IC-LuanPacheco/Projeto-de-IC/README.md

# Projeto-de-IC
Projeto submetido ao PROIC UEL 2023
