IC-LuanPacheco/Projeto-de-IC/Modelos/SolidWorks/Acelerometro_Modificado/Montagem_Experiemnto.SLDASM

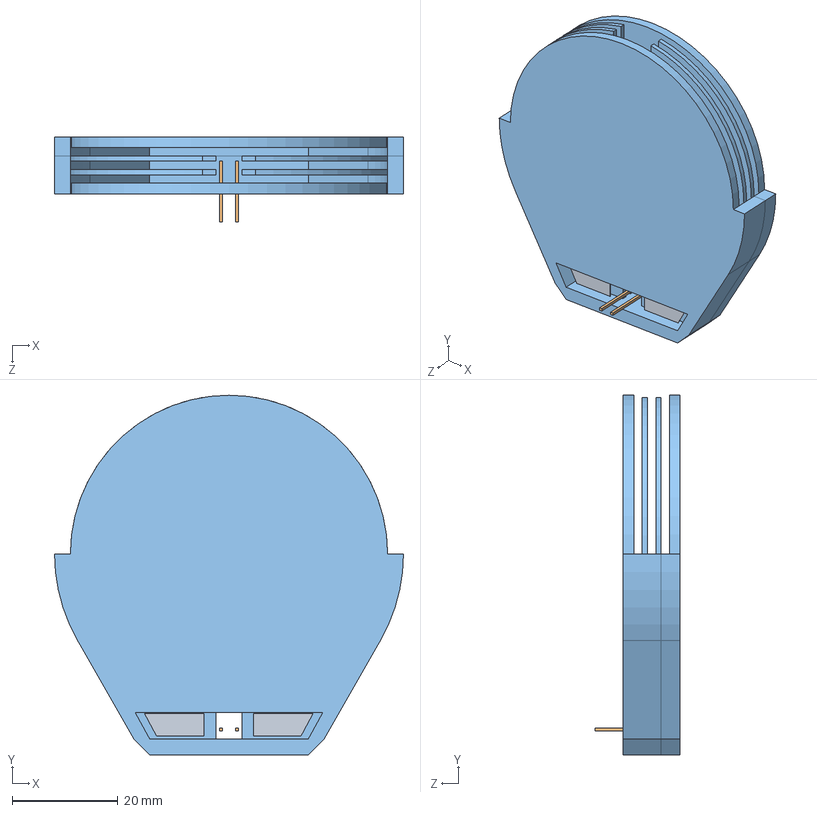
[picture p33: CAD file, 2024-02-15]
Modelos/SolidWorks/Acelerometro_Modificado/Montagem_Experiemnto.SLDASM
66.0 x 68.0 x 16.1 mm
Backup_Espaçador_experimento_tamanho placas
pino x 2
cobre_tampa x 4
