IC-LuanPacheco/Projeto-de-IC/Modelos/SolidWorks/Acelerometro/Acelerometro_Montagem.SLDASM

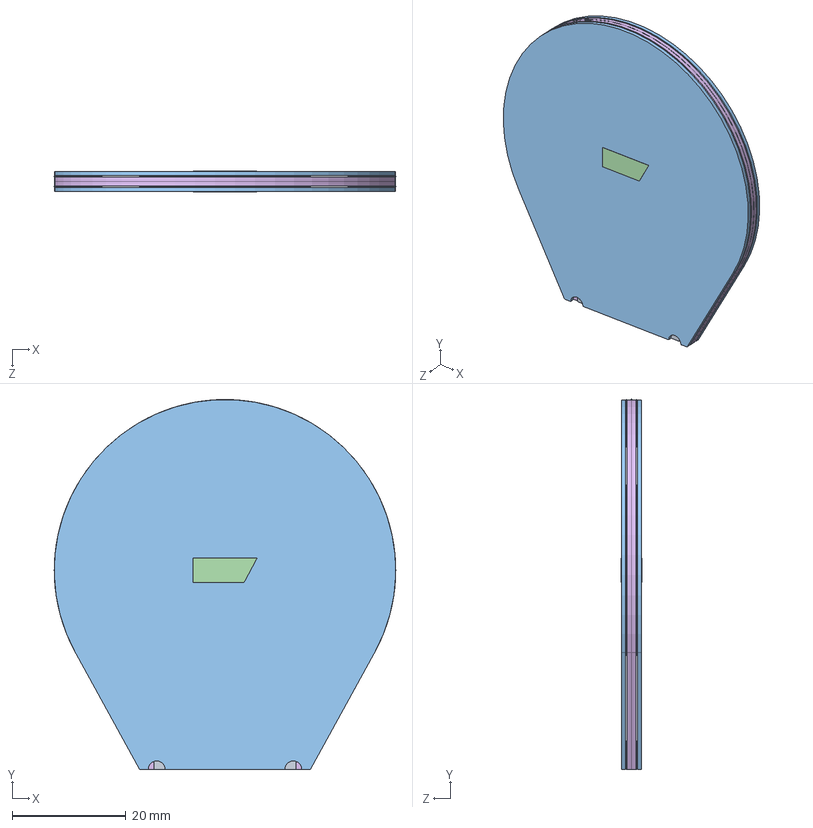
[picture p34: CAD file, 2024-01-25]
Modelos/SolidWorks/Acelerometro/Acelerometro_Montagem.SLDASM
60.0 x 65.0 x 3.67 mm
Dieletrico1 x 2
Cobre_Central
Cobre_tampa x 4
Dieletrico_tampa x 2
Espaçador x 6
Espaçador_inferior x 2
