IC-LuanPacheco/Projeto-de-IC/Modelos/SolidWorks/Acelerometro/Tampa.SLDASM

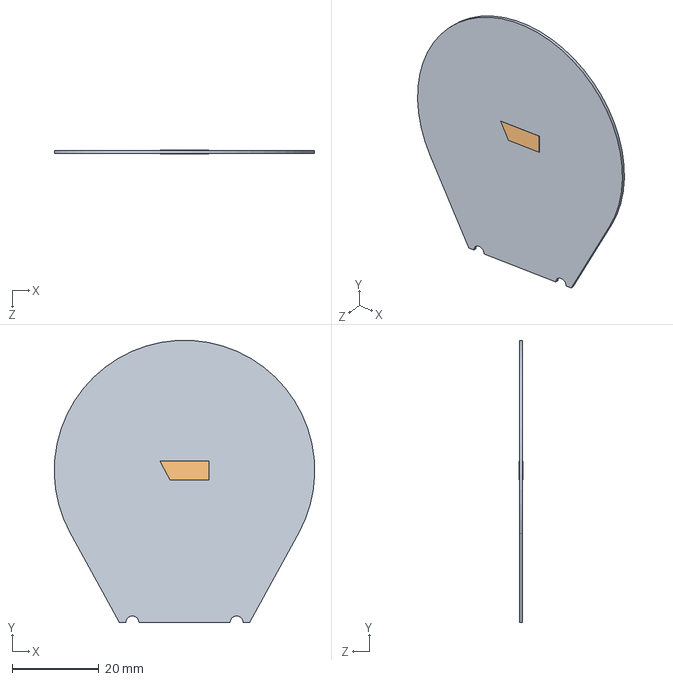
[picture p35: CAD file, 2024-01-25]
Modelos/SolidWorks/Acelerometro/Tampa.SLDASM
60.0 x 64.9 x 0.825 mm
Cobre_tampa x 2
Dieletrico_tampa
