IC-LuanPacheco/Projeto-de-IC/Modelos/Altium/PCB_Project/Step_Placas/Montagem_06_03_24/Tampa_Alinhada.step

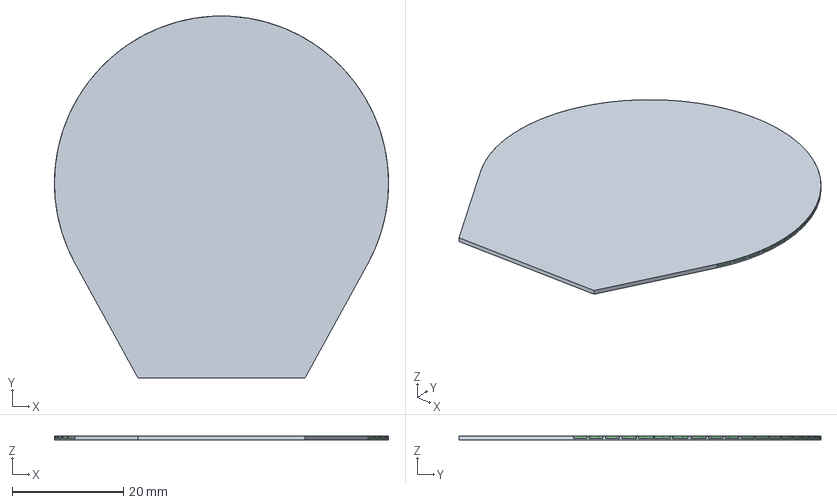
[picture p36: CAD file, 2024-04-25]
Modelos/Altium/PCB_Project/Step_Placas/Montagem_06_03_24/Tampa_Alinhada.step
60.0 x 65.0 x 0.754 mm
Tampa_modelo_3D x 2
