IC-LuanPacheco/Projeto-de-IC/Modelos/Altium/PCB_Project/Step_Placas/Transdutor_Modelo_3D.STEP

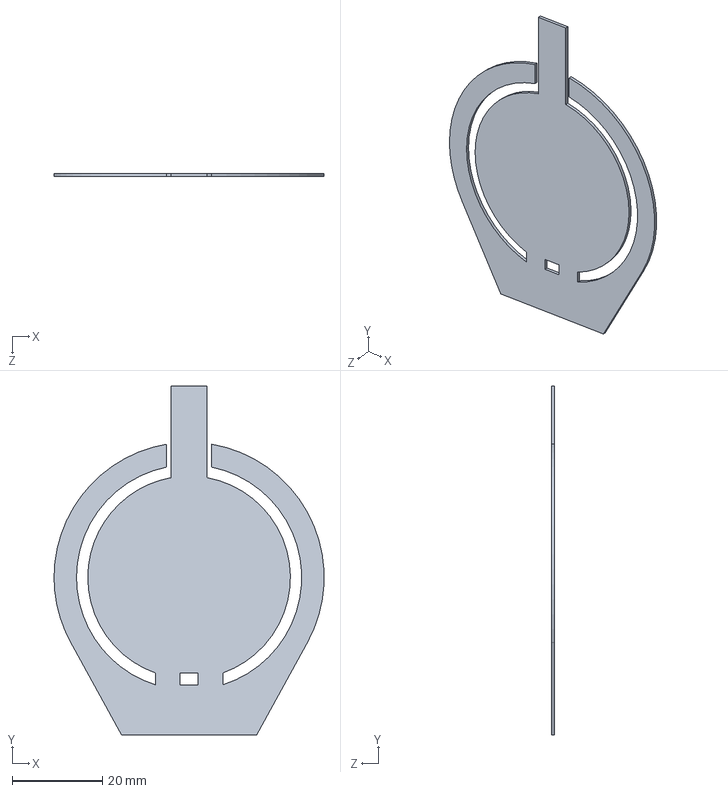
[picture p37: CAD file, 2024-04-25]
Modelos/Altium/PCB_Project/Step_Placas/Transdutor_Modelo_3D.STEP
60.0 x 77.5 x 0.754 mm
