IC-LuanPacheco/Projeto-de-IC/Modelos/SolidWorks/Acelerometro_Modificado/Espaçador_experimento.SLDPRT

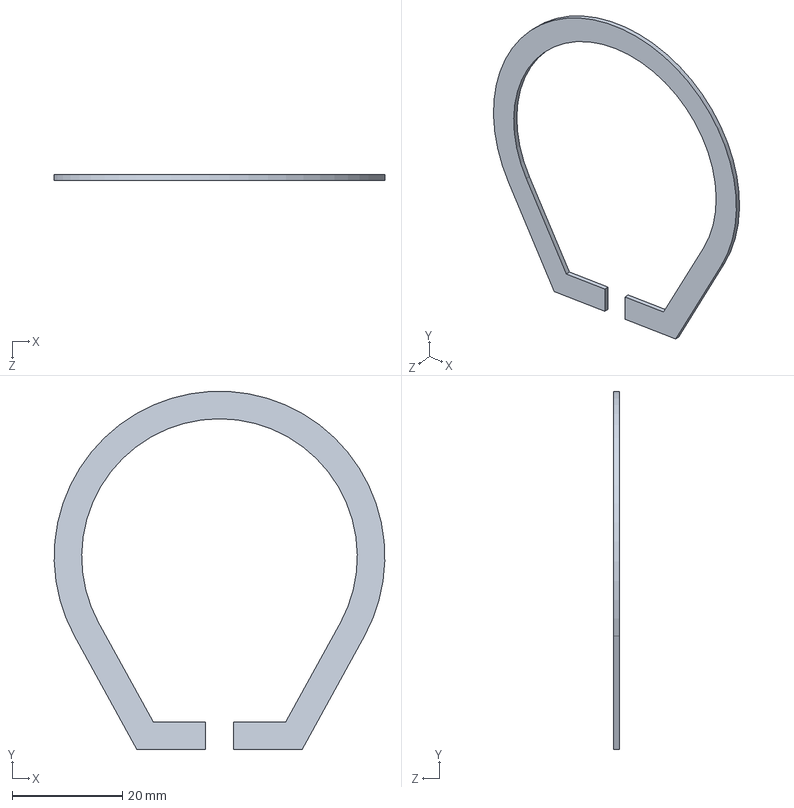
[picture p39: CAD file, 2024-02-15]
Modelos/SolidWorks/Acelerometro_Modificado/Espaçador_experimento.SLDPRT
60.0 x 64.9 x 1.00 mm
