IC-LuanPacheco/Projeto-de-IC/Modelos/SolidWorks/Acelerometro_Modificado/Modelos_Step/Acelerometro_tampa_2.step

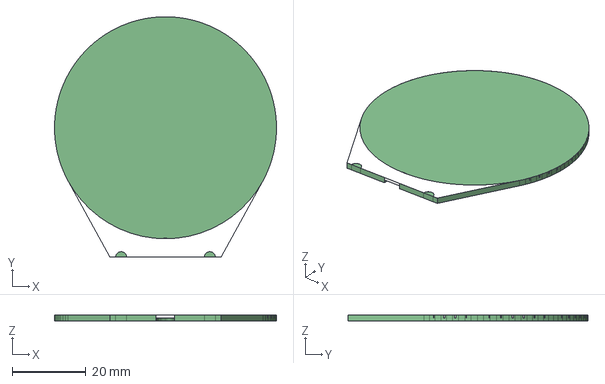
[picture p40: CAD file, 2024-02-15]
Modelos/SolidWorks/Acelerometro_Modificado/Modelos_Step/Acelerometro_tampa_2.step
60.0 x 65.0 x 1.60 mm
