IC-LuanPacheco/Projeto-de-IC/Modelos/Altium/PCB_Project/Step_Placas/Montagem_10_02_24/Acelerometro_4Layers.step

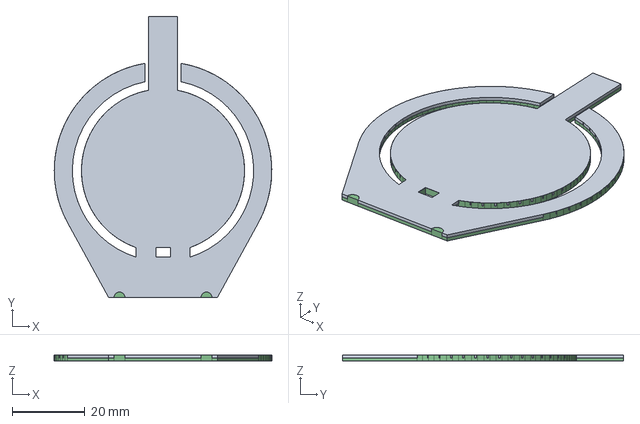
[picture p41: CAD file, 2024-02-15]
Modelos/Altium/PCB_Project/Step_Placas/Montagem_10_02_24/Acelerometro_4Layers.step
60.0 x 77.5 x 1.58 mm
dieletrico_haste_3
