IC-LuanPacheco/Projeto-de-IC/Modelos/Altium/PCB_Project/Step_Placas/tampa_modelo_3d.step.DXF

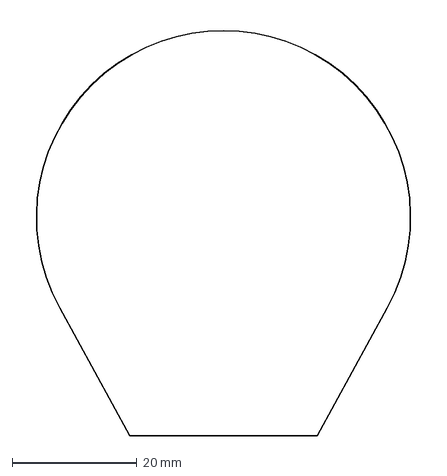
[picture p42: CAD file, 2024-04-25]
Modelos/Altium/PCB_Project/Step_Placas/tampa_modelo_3d.step.DXF
66.5 x 67.3 mm
