IC-LuanPacheco/Projeto-de-IC/Modelos/SolidWorks/Acelerometro/Cobre1.STEP

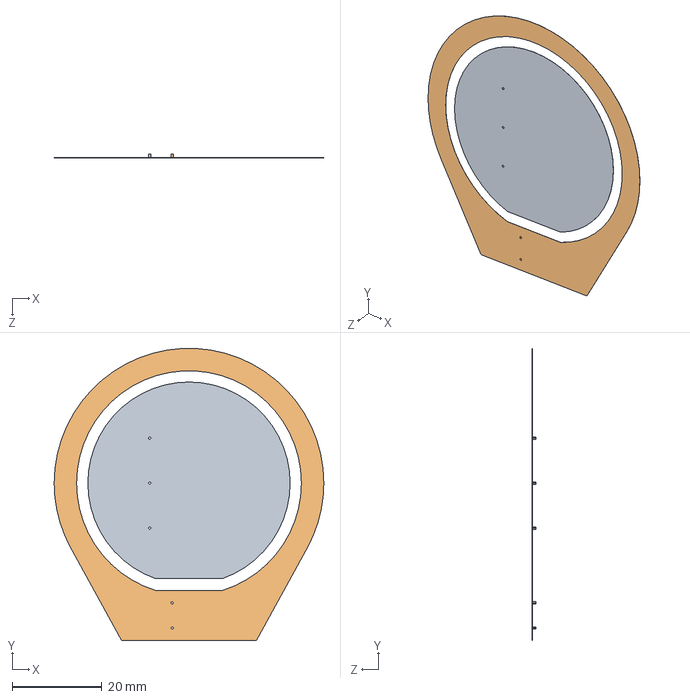
[picture p43: CAD file, 2024-02-07]
Modelos/SolidWorks/Acelerometro/Cobre1.STEP
60.0 x 65.0 x 0.79 mm
