IC-LuanPacheco/Projeto-de-IC/Modelos/SolidWorks/Acelerometro_Modificado/Backup_Espaçador_experimento_tamanho placas.SLDPRT

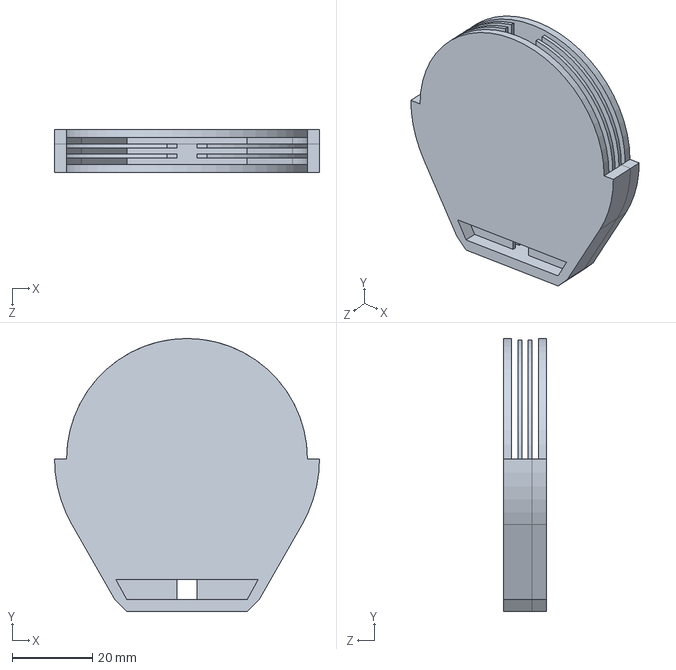
[picture p44: CAD file, 2024-02-15]
Modelos/SolidWorks/Acelerometro_Modificado/Backup_Espaçador_experimento_tamanho placas.SLDPRT
66.0 x 68.0 x 10.8 mm
