IC-LuanPacheco/Projeto-de-IC/Modelos/SolidWorks/Acelerometro_Modificado/Modelos_Step/cobre_tampa.SLDPRT

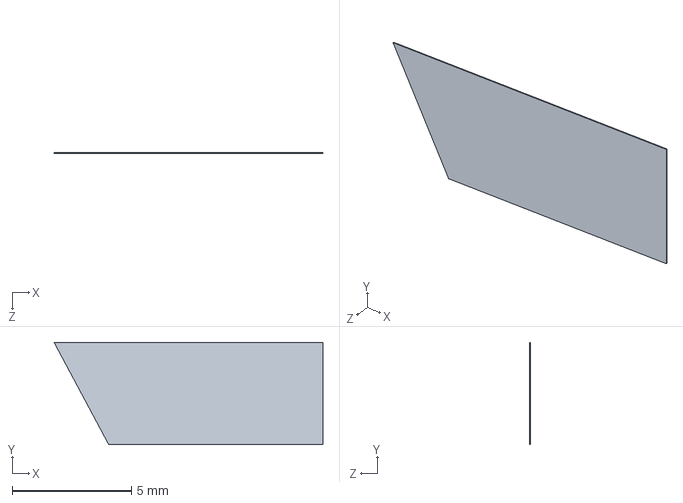
[picture p45: CAD file, 2024-02-15]
Modelos/SolidWorks/Acelerometro_Modificado/Modelos_Step/cobre_tampa.SLDPRT
11.3 x 4.30 x 0.035 mm
