IC-LuanPacheco/Projeto-de-IC/Modelos/Altium/PCB_Project/Step_Placas/Montagem_06_03_24/Transdutor_Alinhado.step

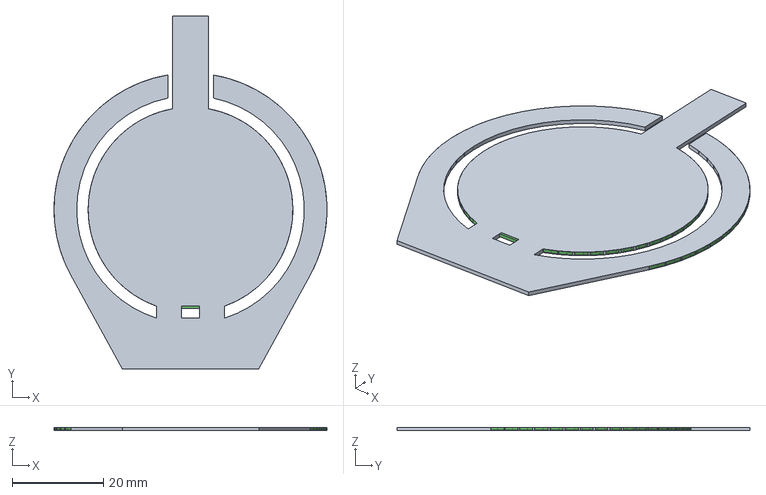
[picture p46: CAD file, 2024-04-25]
Modelos/Altium/PCB_Project/Step_Placas/Montagem_06_03_24/Transdutor_Alinhado.step
60.0 x 77.5 x 0.754 mm
Transdutor_Modelo_3D
