IC-LuanPacheco/Projeto-de-IC/Modelos/Altium/PCB_Project/Step_Placas/Montagem_10_02_24/Acelerometro_tampa_traseira.step

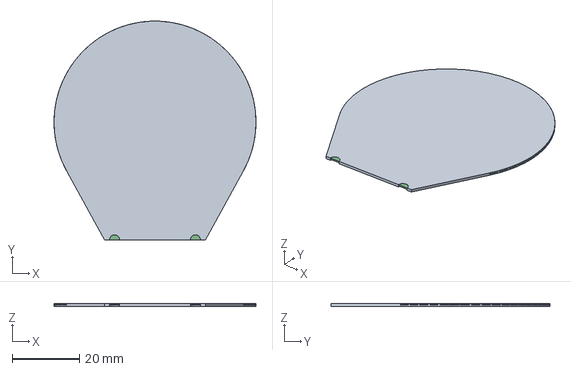
[picture p47: CAD file, 2024-02-15]
Modelos/Altium/PCB_Project/Step_Placas/Montagem_10_02_24/Acelerometro_tampa_traseira.step
60.0 x 65.0 x 0.754 mm
Dieletrico_tampa_frente
