IC-LuanPacheco/Projeto-de-IC/Modelos/Altium/PCB_Project/Step_Placas/Tampa_modelo_3D.STEP

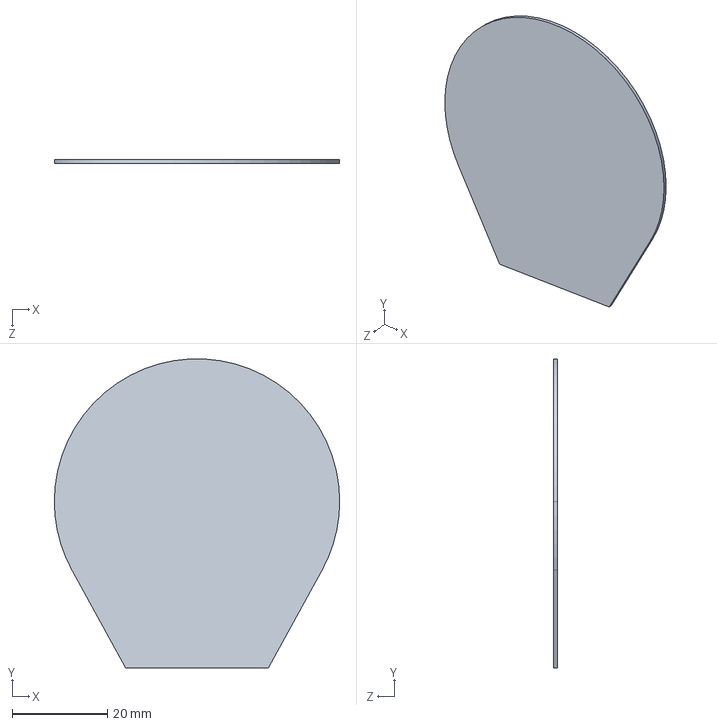
[picture p48: CAD file, 2024-04-25]
Modelos/Altium/PCB_Project/Step_Placas/Tampa_modelo_3D.STEP
60.0 x 65.0 x 0.754 mm
