IC-LuanPacheco/Projeto-de-IC/Modelos/SolidWorks/Acelerometro_Modificado/Modelos_Step/Acelerometro_4Layers.step

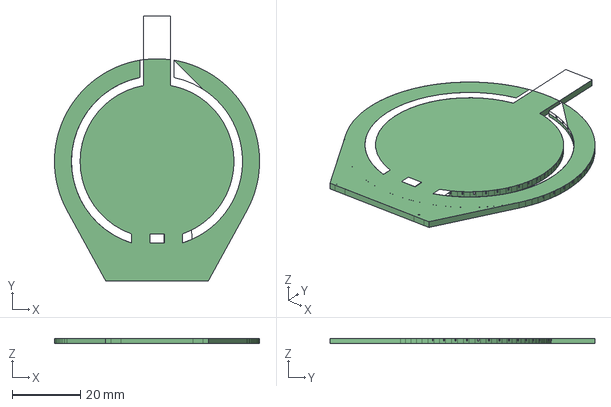
[picture p49: CAD file, 2024-02-15]
Modelos/SolidWorks/Acelerometro_Modificado/Modelos_Step/Acelerometro_4Layers.step
60.0 x 77.5 x 1.58 mm
