IC-LuanPacheco/Projeto-de-IC/Modelos/SolidWorks/Acelerometro/Dieletrico1.SLDPRT

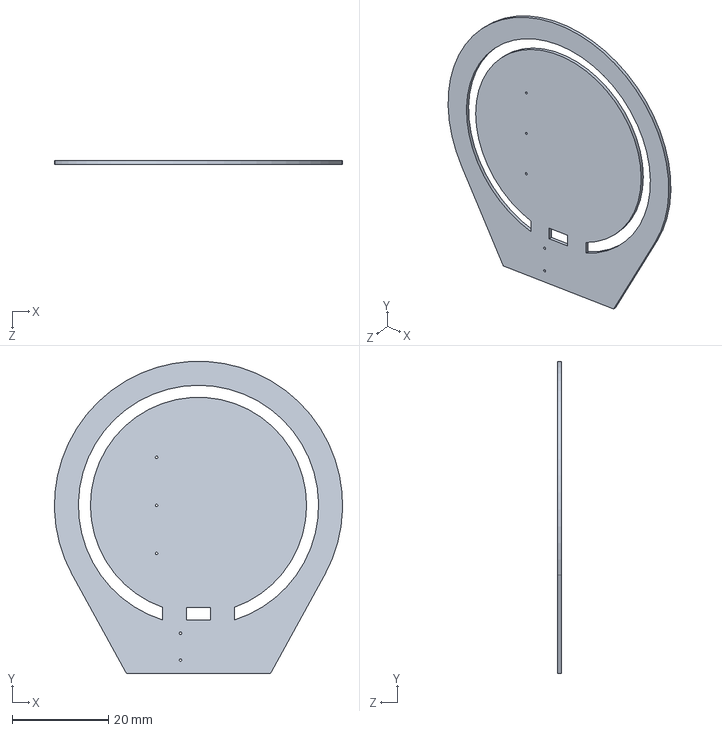
[picture p50: CAD file, 2024-01-25]
Modelos/SolidWorks/Acelerometro/Dieletrico1.SLDPRT
60.0 x 64.9 x 0.754 mm
