IC-LuanPacheco/Projeto-de-IC/Modelos/SolidWorks/Acelerometro_Modificado/Modelos_Step/pino.SLDPRT

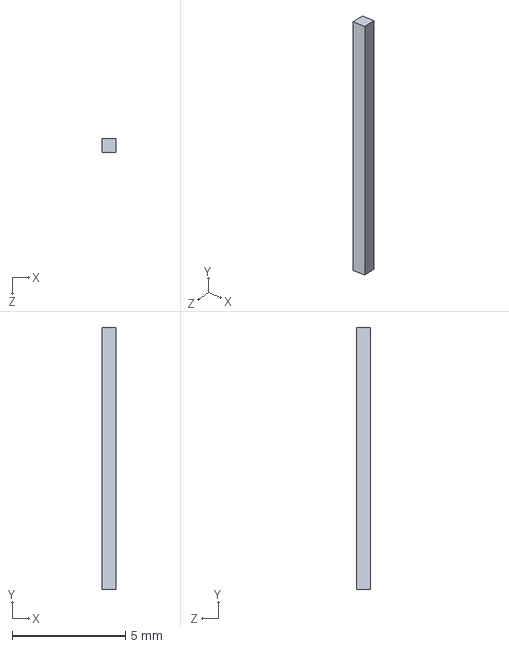
[picture p51: CAD file, 2024-02-15]
Modelos/SolidWorks/Acelerometro_Modificado/Modelos_Step/pino.SLDPRT
0.6 x 11.6 x 0.6 mm
