IC-LuanPacheco/Projeto-de-IC/Modelos/SolidWorks/Acelerometro/Acelerometro_Montagem_Part.SLDPRT

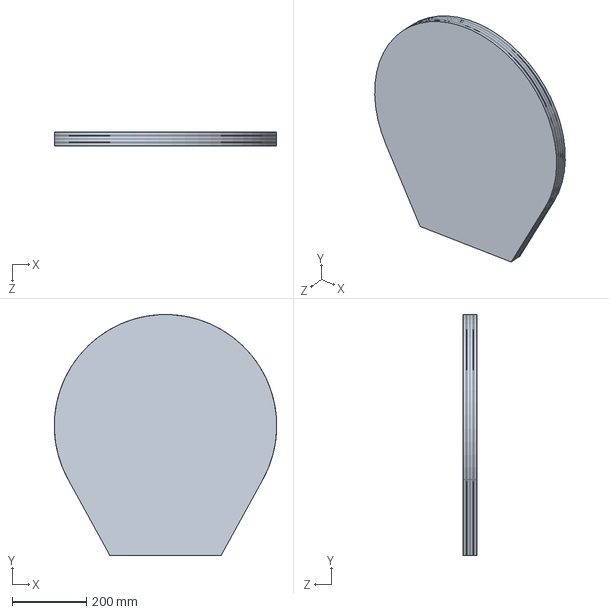
[picture p52: CAD file, 2024-01-25]
Modelos/SolidWorks/Acelerometro/Acelerometro_Montagem_Part.SLDPRT
600.0 x 650.0 x 36.7 mm
