IC-LuanPacheco/Projeto-de-IC/Modelos/Altium/PCB_Project/Step_Placas/Montagem_22_02_24/acelerometro_tampa.STEP

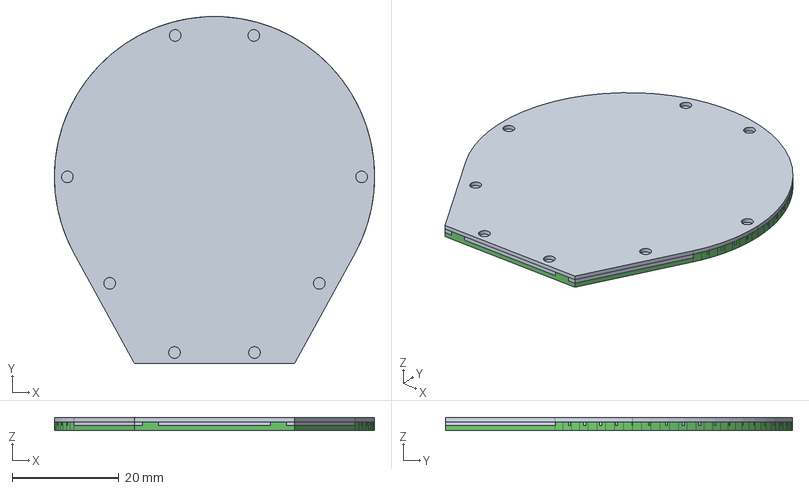
[picture p53: CAD file, 2024-02-22]
Modelos/Altium/PCB_Project/Step_Placas/Montagem_22_02_24/acelerometro_tampa.STEP
60.0 x 65.0 x 2.35 mm
acelerometro_tampa
Dieletrico_tampa_frente
