IC-LuanPacheco/Projeto-de-IC/Modelos/SolidWorks/Acelerometro/Espaçador.SLDPRT

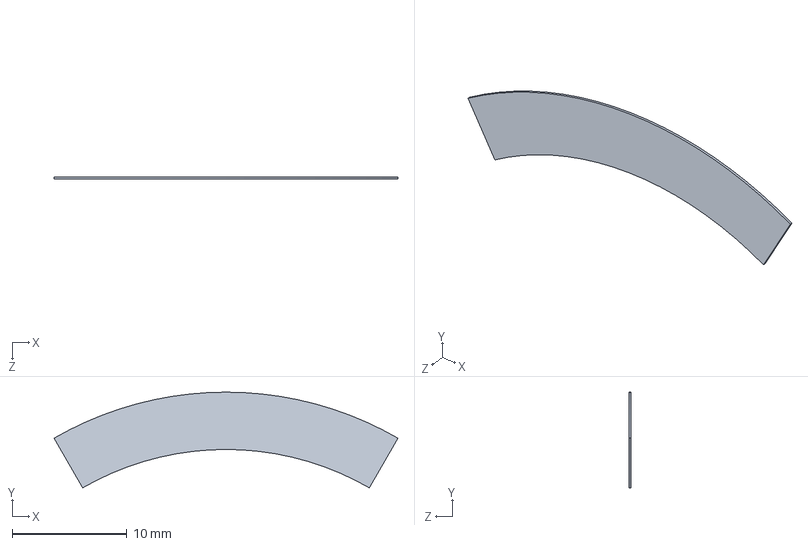
[picture p54: CAD file, 2024-01-25]
Modelos/SolidWorks/Acelerometro/Espaçador.SLDPRT
30.0 x 8.35 x 0.2 mm
