IC-LuanPacheco/Projeto-de-IC/Modelos/SolidWorks/Acelerometro/Cobre_Central.SLDPRT

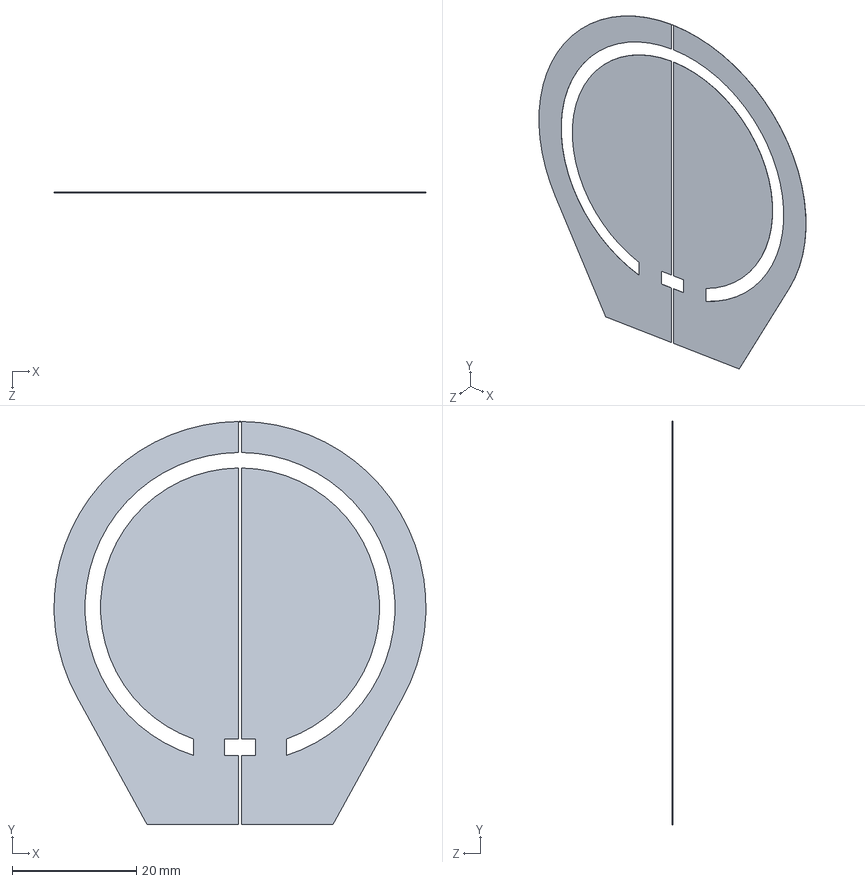
[picture p55: CAD file, 2024-01-25]
Modelos/SolidWorks/Acelerometro/Cobre_Central.SLDPRT
60.0 x 65.0 x 0.0356 mm
