IC-LuanPacheco/Projeto-de-IC/Modelos/SolidWorks/Acelerometro/Cobre_tampa.SLDPRT

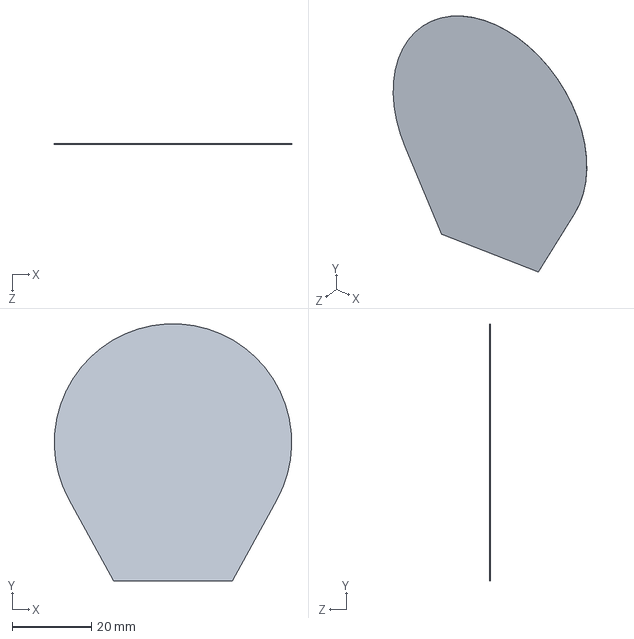
[picture p56: CAD file, 2024-01-25]
Modelos/SolidWorks/Acelerometro/Cobre_tampa.SLDPRT
60.0 x 64.9 x 0.0356 mm
