IC-LuanPacheco/Projeto-de-IC/Modelos/SolidWorks/Acelerometro/Espaçador_inferior.SLDPRT

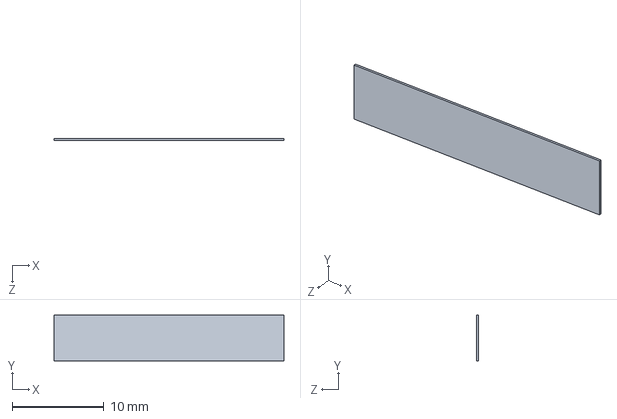
[picture p57: CAD file, 2024-01-25]
Modelos/SolidWorks/Acelerometro/Espaçador_inferior.SLDPRT
25.0 x 5.00 x 0.2 mm
