IC-LuanPacheco/Projeto-de-IC/Modelos/Altium/PCB_Project/Step_Placas/Montagem_22_02_24/acelerometro_tampa_2.SLDPRT

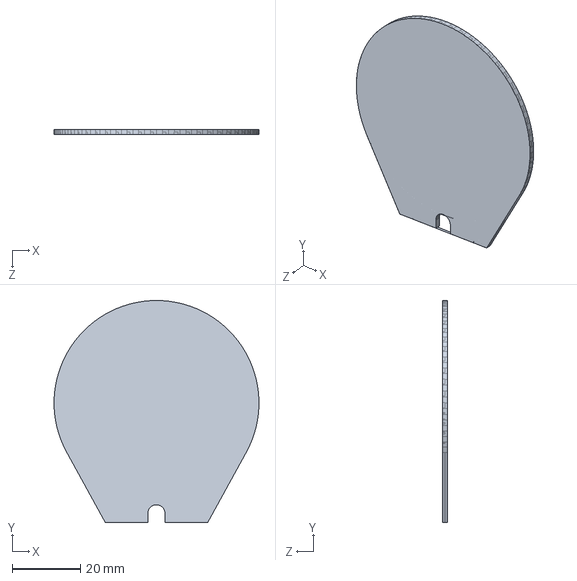
[picture p58: CAD file, 2024-02-15]
Modelos/Altium/PCB_Project/Step_Placas/Montagem_22_02_24/acelerometro_tampa_2.SLDPRT
60.0 x 65.0 x 1.60 mm
