IC-LuanPacheco/Projeto-de-IC/Modelos/Altium/PCB_Project/Step_Placas/Montagem_06_03_24/Montagem_06_03_24.SLDASM

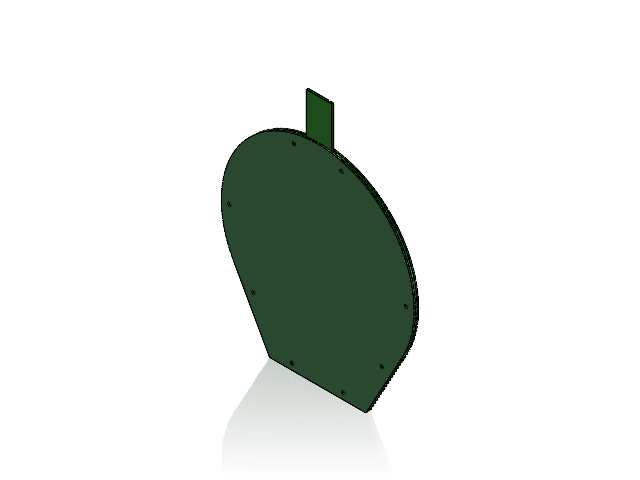
[picture p59: CAD file, 2024-04-25]
Modelos/Altium/PCB_Project/Step_Placas/Montagem_06_03_24/Montagem_06_03_24.SLDASM
