IC-LuanPacheco/Projeto-de-IC/Modelos/Altium/PCB_Project/Step_Placas/Montagem_22_02_24/Mont1.SLDASM

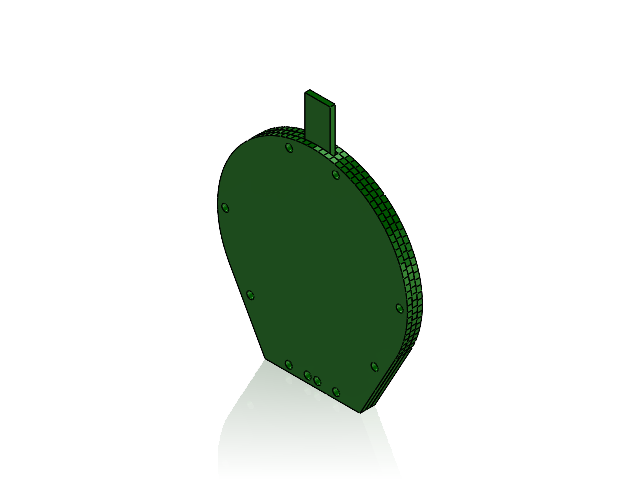
[picture p60: CAD file, 2024-02-22]
Modelos/Altium/PCB_Project/Step_Placas/Montagem_22_02_24/Mont1.SLDASM
