IC-LuanPacheco/Projeto-de-IC/(list of files, cad)

Other CAD files:
Modelos/Altium/PCB_Project/Step_Placas/Montagem_10_02_24/Board_1.step.SLDASM
Modelos/Altium/PCB_Project/Step_Placas/Montagem_06_03_24/Board_1.step.SLDASM
Modelos/Altium/PCB_Project/Step_Placas/Montagem_22_02_24/Board_3.step.SLDASM
Modelos/Altium/PCB_Project/Step_Placas/Montagem_22_02_24/Board_6.STEP.SLDASM
Modelos/Altium/PCB_Project/Step_Placas/Montagem_22_02_24/Board_4.step.SLDASM
Modelos/Altium/PCB_Project/Step_Placas/Montagem_22_02_24/Board_2.step.SLDASM
Modelos/Altium/PCB_Project/Step_Placas/Montagem_22_02_24/Open CASCADE STEP translator 7.5 2.1.1.STEP.SLDPRT
Modelos/Altium/PCB_Project/Step_Placas/Montagem_22_02_24/Dieletrico_tampa_frente.STEP.SLDPRT
Modelos/Altium/PCB_Project/Step_Placas/Montagem_22_02_24/Acelerometro_4Layers.step
Modelos/SolidWorks/Acelerometro/Dieletrico_tampa.SLDPRT
Modelos/Altium/PCB_Project/Step_Placas/Montagem_06_03_24/Open CASCADE STEP translator 7.5 4.1.1.step.SLDPRT
Modelos/Altium/PCB_Project/Step_Placas/Montagem_10_02_24/Acelerometro_tampa_frontal.step
Modelos/Altium/PCB_Project/Step_Placas/Montagem_22_02_24/Open CASCADE STEP translator 7.5 2.1.1_1.STEP.SLDPRT
Modelos/SolidWorks/Acelerometro_Modificado/dieletrico_haste_2.STEP
Modelos/SolidWorks/Acelerometro_Modificado/Dieletrico_tampa_frente.STEP
Modelos/Altium/PCB_Project/Step_Placas/Montagem_22_02_24/Dieletrico_tampa.SLDPRT
Modelos/SolidWorks/Acelerometro_Modificado/dieletrico_haste_3.STEP
Modelos/SolidWorks/Acelerometro_Modificado/dieletrico_haste.STEP
Modelos/SolidWorks/Acelerometro_Modificado/estudo_dimensoes.SLDPRT
Modelos/SolidWorks/Acelerometro/estudo_dimensoes.SLDPRT
Modelos/SolidWorks/Acelerometro/Cobre1.SLDPRT
Modelos/SolidWorks/Acelerometro_Modificado/Modelos_Step/acelerometro_4layers.SLDPRT
Modelos/SolidWorks/Acelerometro_Modificado/dieletrico_haste.SLDPRT
