IC-LuanPacheco/Projeto-de-IC/(list of files, drawings)

Other design files:
Modelos/Altium/PCB_Project/Acelerometro_tampa_frente.PcbDoc
Modelos/Altium/PCB_Project/Biblioteca_Squematico.SchLib
Modelos/Altium/PCB_Project/Nets_Acelerometro.SchDoc
Modelos/Altium/PCB_Project/PCB_Lib_Acelerometro.PcbLib
Modelos/Altium/PCB_Project/PCB_Project.PrjPcb
Modelos/Altium/PCB_Project/Tampa_Alinhada.PcbDoc
Modelos/Altium/PCB_Project/Transdutir_Alinhado.PcbDoc
