IC-LuanPacheco/Projeto-de-IC/(commit log)

2023-12-15 Vista explodida
    [Acelerometro_Montagem.SLDASM]
2024-01-25 Atualizações
    [Acel_PCB1.PcbDoc, Acel_PCB1.step, Acel_Sheet1.SchDoc, Acelerometro_Capacitivo.PrjPcb, Acelerometro_Montagem.SLDASM, Acelerometro_Montagem_Part.SLDPRT, Capacitor_Peca_Interna.STEP, Cobre1.SLDPRT]
2024-02-07 atualizacoes do modelo para o experimento Altium
    [Acel_PCB1.PcbDoc, Acel_PCB1.step, Acel_Sheet1.SchDoc, Acelerometro_4Layers.PcbDoc, Acelerometro_Capacitivo.PrjPcb, Acelerometro_Montagem.SLDASM, Acelerometro_Montagem_Part.SLDPRT, Acelerometro_Tampa.PrjPcb]
2024-02-11 Atualizações do transdutor e placas paralelas
    [Acel_PCB1.PcbDoc, Acel_PCB1.step, Acel_Sheet1.SchDoc, Acelerometro_4Layers.PcbDoc, Acelerometro_Capacitivo.PrjPcb, Acelerometro_Tampa.PrjPcb, Acelerometro_tampa_frente.PcbDoc, Acelerometro_tampa_sheet.SchDoc]
2024-02-15 Montagem SolidWorks e Placas prontas no Altiunm
    [Acelerometro_4Layers.PcbDoc, Acelerometro_4Layers.step, Acelerometro_Montagem_step.STEP, Acelerometro_tampa_2.PcbDoc, Acelerometro_tampa_2.step, Acelerometro_tampa_frente.PcbDoc, Acelerometro_tampa_frontal.step, Acelerometro_tampa_traseira.step]
2024-02-22 Pasta -Altium- atualizada, modelo do capacitor com furos para fixacao
    [Acelerometro_4Layers.PcbDoc, Acelerometro_4Layers.step, Acelerometro_tampa_2.PcbDoc, Acelerometro_tampa_frontal.step, Acelerometro_tampa_traseira.step, Biblioteca_Squematico.SchLib, Board_1.step.SLDASM, Board_2.step.SLDASM]
2024-04-25 Placas finais
    [Acelerometro_4Layers.PcbDoc, Acelerometro_4Layers.step, Acelerometro_tampa_2.PcbDoc, Acelerometro_tampa_frontal.step, Acelerometro_tampa_traseira.step, Board_1.step.SLDASM, Dieletrico_tampa_frente.STEP.SLDPRT, Montagem_06_03_24.SLDASM]
2024-04-29 sei la
    [Transdutir_Alinhado.PcbDoc]
